skillzy8/Planetary-gear-box-NEMA17-stepper-motor/Bottom part/readme.md

This is the botoom part section of the gear box
