skillzy8/Planetary-gear-box-NEMA17-stepper-motor/Bottom part/Bottomshell.step

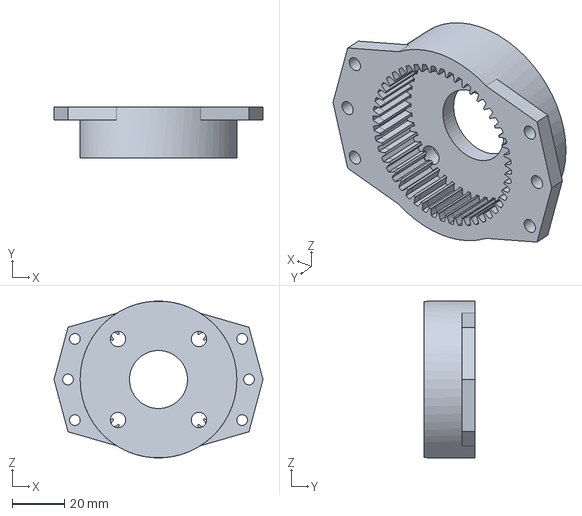
[picture p1: CAD file, 2026-03-16]
Bottom part/Bottomshell.step
80.0 x 19.5 x 60.0 mm
