skillzy8/Planetary-gear-box-NEMA17-stepper-motor/Top part/Second Output Ring.stl

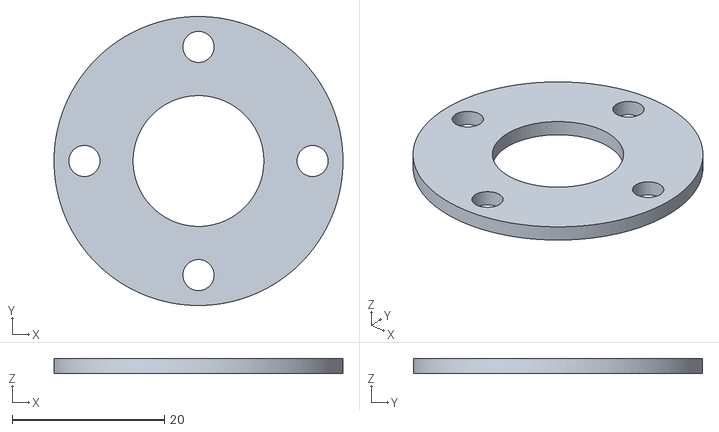
[picture p2: CAD file, 2026-03-16]
Top part/Second Output Ring.stl
38.0 x 38.0 x 2.00
