skillzy8/Planetary-gear-box-NEMA17-stepper-motor/Bottom part/Sun gear.stl

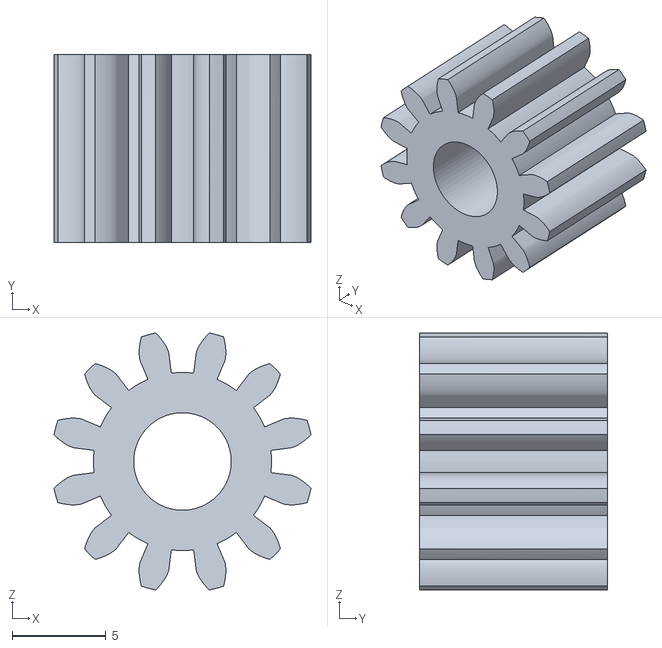
[picture p3: CAD file, 2026-03-16]
Bottom part/Sun gear.stl
13.7 x 10.0 x 13.7
