skillzy8/Planetary-gear-box-NEMA17-stepper-motor/Top part/Second gear set.stl

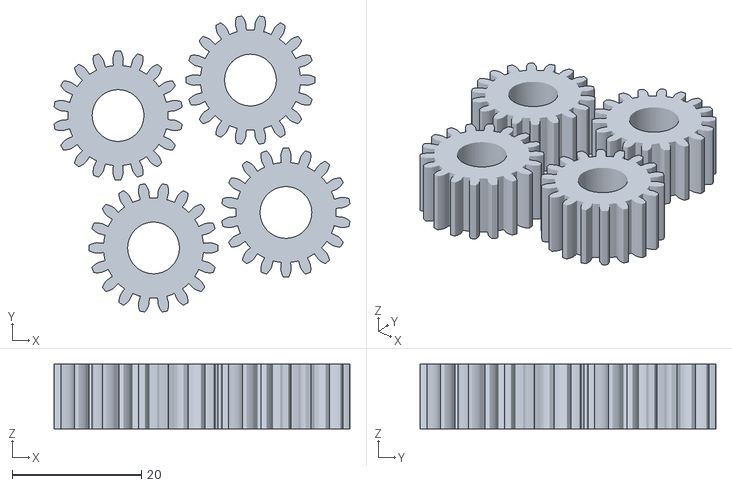
[picture p4: CAD file, 2026-03-16]
Top part/Second gear set.stl
45.8 x 45.8 x 10.0
