skillzy8/Planetary-gear-box-NEMA17-stepper-motor/Bottom part/First gear holder.stl

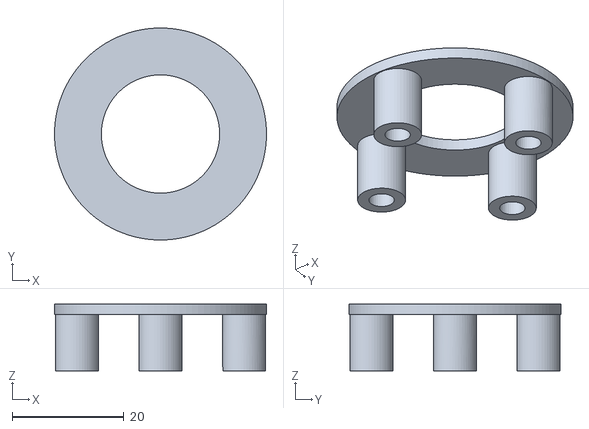
[picture p5: CAD file, 2026-03-16]
Bottom part/First gear holder.stl
38.0 x 38.0 x 12.0
