skillzy8/Planetary-gear-box-NEMA17-stepper-motor/Top part/second shell.stl

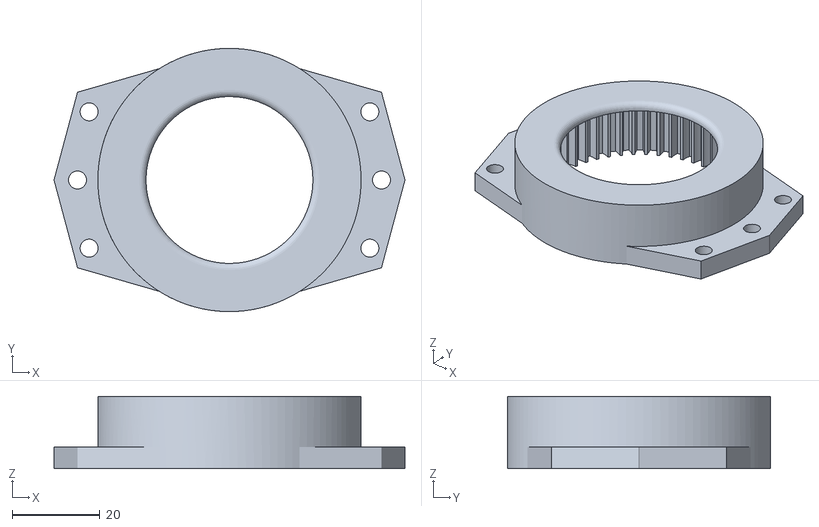
[picture p6: CAD file, 2026-03-16]
Top part/second shell.stl
80.0 x 60.0 x 16.5
