skillzy8/Planetary-gear-box-NEMA17-stepper-motor/Bottom part/First Output Ring.stl

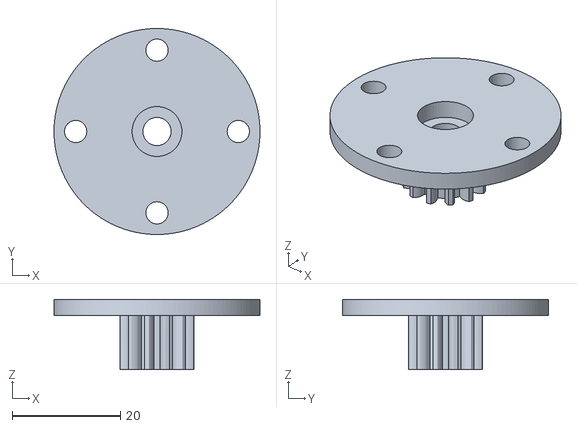
[picture p7: CAD file, 2026-03-16]
Bottom part/First Output Ring.stl
38.0 x 38.0 x 13.0
