skillzy8/Planetary-gear-box-NEMA17-stepper-motor/Bottom part/First Gear Set.stl

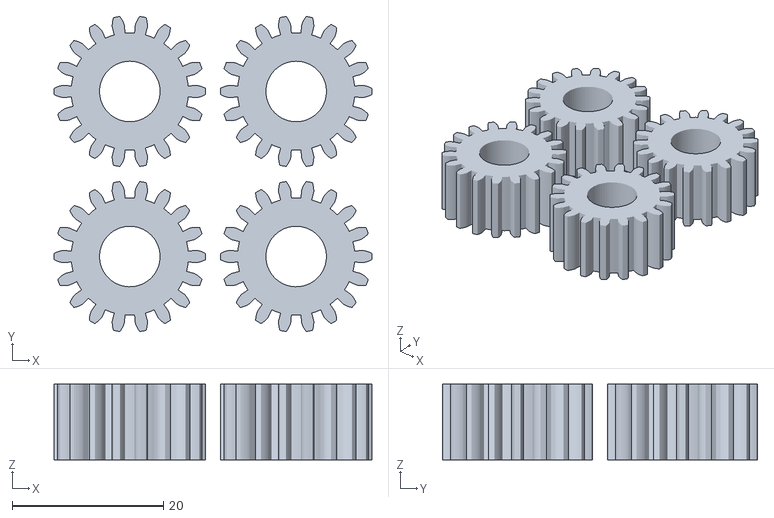
[picture p8: CAD file, 2026-03-16]
Bottom part/First Gear Set.stl
42.0 x 41.7 x 10.0
