skillzy8/Planetary-gear-box-NEMA17-stepper-motor/(list of files, cad)

Other CAD files:
Bottom part/Bottom shell.stl
